euphy/polarshield_hardware/README.md

Polarshield Hardware
====================

This is the source for the Polarshield hardware, in EAGLE format.  
I have also included the last set of generated Gerber files that were used to make
the most recent batch of PCBs. These can be purchased through polargraph.bigcartel.com.
