euphy/polarshield_hardware/Polarshield v2.5.brd.png

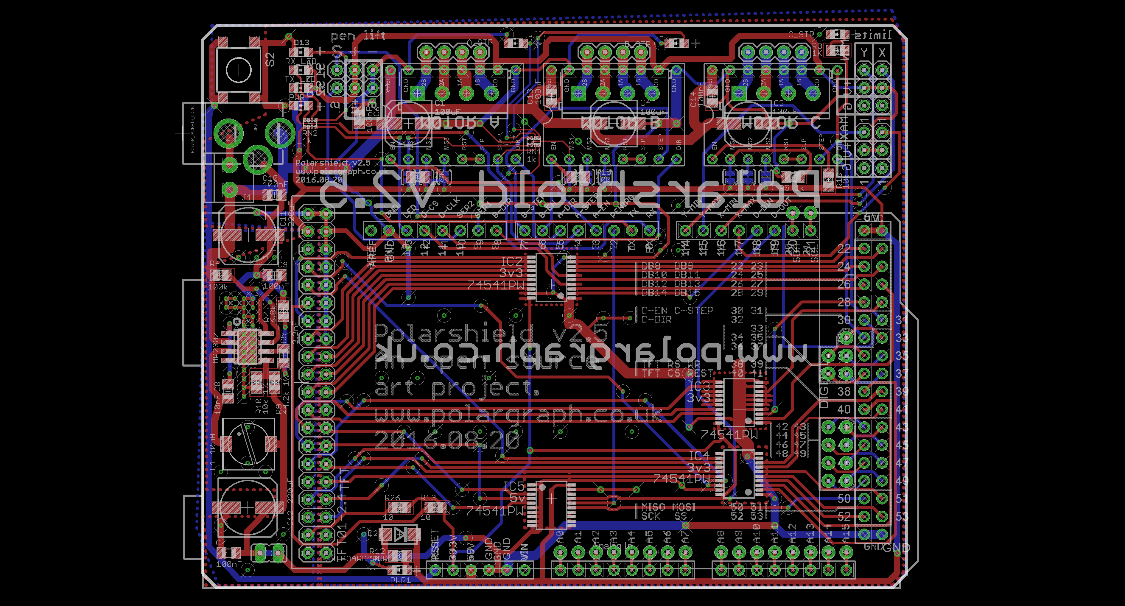
Polarshield v2.5.brd.png
