euphy/polarshield_hardware/Polarshield v2.5.sch.png

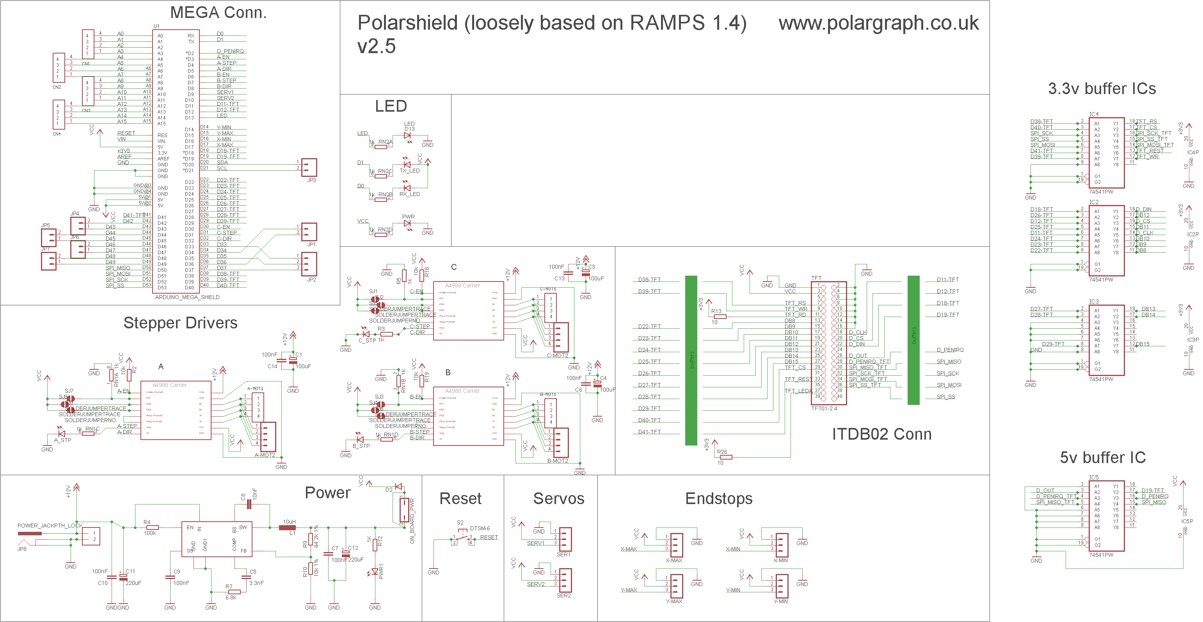
Polarshield v2.5.sch.png
