euphy/polarshield_hardware/Polarshield v2.6.brd

## EAGLE design Polarshield v2.6.brd (2017-02-12)

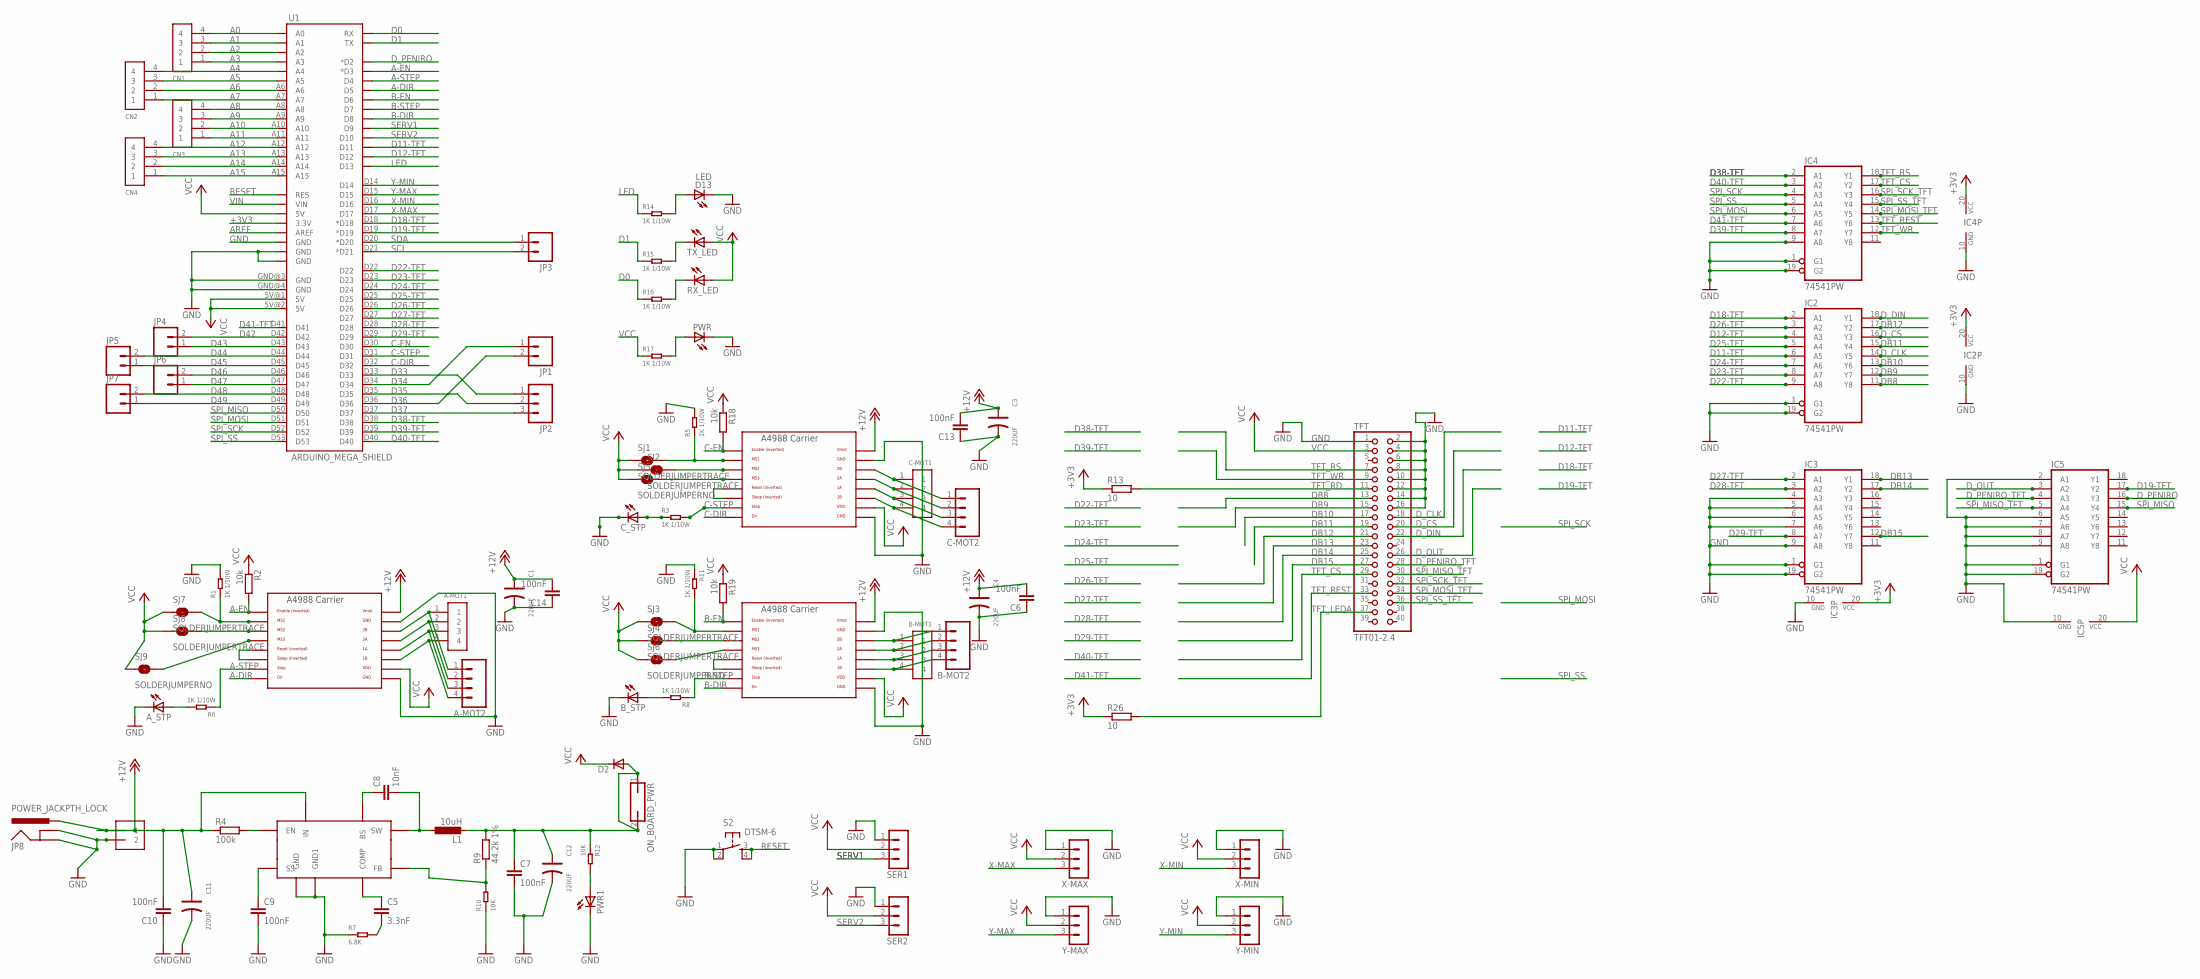
[picture p3: schematic Polarshield v2.6.sch]

Parts:
A-MOT1: 1X4-BIG; 1X04-BIG
A-MOT2: M04SCREW; SCREWTERMINAL-3.5MM-4
A_STP: LEDCHIP-LED0805; CHIP-LED0805
B-MOT1: 1X4-BIG; 1X04-BIG
B-MOT2: M04SCREW; SCREWTERMINAL-3.5MM-4
B_STP: LEDCHIP-LED0805; CHIP-LED0805
C1, C3, C4, C11, C12: 220UF; ELECTRO-SMD-C-6MM
C5: 3.3nF; C0402K
C6, C7, C9, C10, C13, C14: 100nF; C0402K
C8: 10nF; C0402K
C-MOT1: 1X4-BIG; 1X04-BIG
C-MOT2: M04SCREW; SCREWTERMINAL-3.5MM-4
CN1, CN2, CN3, CN4: 1X4-CLEANBIG; 1X04-CLEANBIG
C_STP: LEDCHIP-LED0805; CHIP-LED0805
D2: DIODE-DO214BA; DO214BA
D13: LED; CHIP-LED0805
IC1: MP2307; SOIC8
IC2, IC3, IC4, IC5: 74541PW; TSSOP20
J1: 1X2-3.5MM
JP1, JP3, JP4, JP5, JP6, JP7: M021X02_NO_SILK; 1X02_NO_SILK
JP2: M031X03_NO_SILK; 1X03_NO_SILK
JP8: POWER_JACKPTH_LOCK; POWER_JACK_PTH_LOCK
L1: 10uH; PIS2816
ON_BOARD_PWR: JP1Q; JP1
PWR, PWR1: LEDCHIP-LED0805; CHIP-LED0805
R1, R3, R5, R6, R8, R11, R14, R15, R16, R17: 1K 1/10W; R0603
R2, R18, R19: 10k; R0402
R4: 100k; R0603
R7: 6.8K; R0603
R9: 44.2k 1%; R0603
R10: 10K; R0805
R12: 10K; R0603
R13, R26: 10; R0603
RX_LED: LEDCHIP-LED0805; CHIP-LED0805
S2: DTSM-6
SER1, SER2: 3PIN-HEADER
SJ1, SJ2, SJ3, SJ4, SJ7, SJ8: SOLDERJUMPERTRACE; SJ_2S-TRACE
SJ5, SJ6, SJ9: SOLDERJUMPERNO; SJ_2S-NO
TFT: TFT01-2.4
TX_LED: LEDCHIP-LED0805; CHIP-LED0805
U1: ARDUINO_MEGA_SHIELD
U$1, U$6, U$7: A4988BREAKOUT
X-MAX: 3PIN-HEADER
X-MIN: 3PIN-HEADER
Y-MAX: 3PIN-HEADER
Y-MIN: 3PIN-HEADER

Connections:
+3V3: IC2.20 (VCC), IC3.20 (VCC), IC4.20 (VCC), R13.1, R26.1, U1.3.3V
+12V: C1.+, C3.+, C4.+, C6.2, C10.2, C11.+, C13.2, C14.2, IC1.IN, J1.1, JP8.PWR, R4.1, U$1.VMOT, U$6.VMOT, U$7.VMOT
A0: CN1.4, U1.A0
A1: CN1.3, U1.A1
A2: CN1.2, U1.A2
A3: CN1.1, U1.A3
A4: CN2.4, U1.A4
A5: CN2.3, U1.A5
A6: CN2.2, U1.A6
A7: CN2.1, U1.A7
A8: CN3.4, U1.A8
A9: CN3.3, U1.A9
A10: CN3.2, U1.A10
A11: CN3.1, U1.A11
A12: CN4.4, U1.A12
A13: CN4.3, U1.A13
A14: CN4.2, U1.A14
A15: CN4.1, U1.A15
A-DIR: U1.D5, U$1.DIR
A-EN: R2.2, U1.D3 (*D3), U$1.EN
A-STEP: R6.1, U1.D4, U$1.STEP
AREF: U1.AREF
B-DIR: U1.D8, U$7.DIR
B-EN: R19.2, U1.D6, U$7.EN
B-STEP: R8.1, U1.D7, U$7.STEP
C-DIR: U1.D32, U$6.DIR
C-EN: R18.2, U1.D30, U$6.EN
C-STEP: R3.2, U1.D31, U$6.STEP
D0: R16.1, U1.RX
D1: R15.1, U1.TX
D11-TFT: IC2.6 (A5), U1.D11
D12-TFT: IC2.4 (A3), U1.D12
D18-TFT: IC2.2 (A1), U1.D18 (*D18)
D19-TFT: IC5.17 (Y2), U1.D19 (*D19)
D22-TFT: IC2.9 (A8), U1.D22
D23-TFT: IC2.8 (A7), U1.D23
D24-TFT: IC2.7 (A6), U1.D24
D25-TFT: IC2.5 (A4), U1.D25
D26-TFT: IC2.3 (A2), U1.D26
D27-TFT: IC3.2 (A1), U1.D27
D28-TFT: IC3.3 (A2), U1.D28
D29-TFT: IC3.8 (A7), U1.D29
D33: JP2.1, U1.D33
D34: JP1.1, U1.D34
D35: JP2.2, U1.D35
D36: JP1.2, U1.D36
D37: JP2.3, U1.D37
D38-TFT: IC4.2 (A1), U1.D38
D39-TFT: IC4.8 (A7), U1.D39
D40-TFT: IC4.3 (A2), U1.D40
D41-TFT: IC4.7 (A6), U1.D41
D42: JP4.2, U1.D42
D43: JP4.1, U1.D43
D44: JP5.2, U1.D44
D45: JP5.1, U1.D45
D46: JP6.2, U1.D46
D47: JP6.1, U1.D47
D48: JP7.2, U1.D48
D49: JP7.1, U1.D49
DB8: IC2.11 (Y8), TFT.13
DB9: IC2.12 (Y7), TFT.15
DB10: IC2.13 (Y6), TFT.17
DB11: IC2.15 (Y4), TFT.19
DB12: IC2.17 (Y2), TFT.21
DB13: IC3.18 (Y1), TFT.23
DB14: IC3.17 (Y2), TFT.25
DB15: IC3.12 (Y7), TFT.27
D_CLK: IC2.14 (Y5), TFT.18
D_CS: IC2.16 (Y3), TFT.20
D_DIN: IC2.18 (Y1), TFT.22
D_OUT: IC5.3 (A2), TFT.26
D_PENIRQ: IC5.16 (Y3), U1.D2 (*D2)
D_PENIRQ_TFT: IC5.4 (A3), TFT.28
GND: A_STP.C, B_STP.C, C1.-, C3.-, C4.-, C6.1, C7.2, C9.2, C10.1, C11.-, C12.-, C13.1, C14.1, C_STP.C, D13.C, IC1.GND, IC1.GND1, IC2.1 (G1), IC2.10 (GND), IC2.19 (G2), IC3.1 (G1), IC3.4 (A3), IC3.5 (A4), IC3.6 (A5), IC3.7 (A6), IC3.9 (A8), IC3.10 (GND), IC3.19 (G2), IC4.1 (G1), IC4.9 (A8), IC4.10 (GND), IC4.19 (G2), IC5.1 (G1), IC5.2 (A1), IC5.6 (A5), IC5.7 (A6), IC5.8 (A7), IC5.9 (A8), IC5.10 (GND), IC5.19 (G2), J1.2, JP8.GND, JP8.GNDBREAK, PWR.C, PWR1.C, R1.2, R5.2, R7.1, R10.1, R11.1, S2.1, S2.2, SER1.1, SER2.1, TFT.1, TFT.2, TFT.4, TFT.6, TFT.8, TFT.10, TFT.12, TFT.14, TFT.16, U1.GND@0 (GND), U1.GND@1 (GND), U1.GND@2 (GND), U1.GND@3 (GND), U1.GND@4 (GND), U$1.GND, U$1.GND@0 (GND), U$6.GND, U$6.GND@0 (GND), U$7.GND, U$7.GND@0 (GND), X-MAX.1, X-MIN.1, Y-MAX.1, Y-MIN.1
LED: R14.1, U1.D13
unnamed: U$6.RST, U$6.SLP (SLEEP)
unnamed: PWR.A, R17.2
unnamed: R5.1, SJ1.2, U$6.MS1
unnamed: A-MOT1.1, A-MOT2.1, U$1.2B
unnamed: A-MOT1.2, A-MOT2.2, U$1.2A
unnamed: A-MOT1.3, A-MOT2.3, U$1.1A
unnamed: A-MOT1.4, A-MOT2.4, U$1.1B
unnamed: U$1.RST, U$1.SLP (SLEEP)
unnamed: R1.1, SJ7.2, U$1.MS1
unnamed: SJ2.2, U$6.MS2
unnamed: SJ8.2, U$1.MS2
unnamed: SJ5.2, U$6.MS3
unnamed: U$7.RST, U$7.SLP (SLEEP)
unnamed: SJ9.2, U$1.MS3
unnamed: R16.2, RX_LED.C
unnamed: R15.2, TX_LED.C
unnamed: SJ4.2, U$7.MS2
unnamed: B_STP.A, R8.2
unnamed: A_STP.A, R6.2
unnamed: D13.A, R14.2
unnamed: C-MOT1.1, C-MOT2.1, U$6.2B
unnamed: C-MOT1.2, C-MOT2.2, U$6.2A
unnamed: C_STP.A, R3.1
unnamed: C7.1, C12.+, D2.A, L1.2, ON_BOARD_PWR.1, ON_BOARD_PWR.2, R9.2, R12.1
unnamed: PWR1.A, R12.2
unnamed: C-MOT1.3, C-MOT2.3, U$6.1A
unnamed: C-MOT1.4, C-MOT2.4, U$6.1B
unnamed: B-MOT1.1, B-MOT2.1, U$7.2B
unnamed: B-MOT1.2, B-MOT2.2, U$7.2A
unnamed: B-MOT1.3, B-MOT2.3, U$7.1A
unnamed: SJ6.2, U$7.MS3
unnamed: IC1.FB, R9.1, R10.2
unnamed: R11.2, SJ3.2, U$7.MS1
unnamed: IC1.EN, R4.2
unnamed: B-MOT1.4, B-MOT2.4, U$7.1B
unnamed: C9.1, IC1.SS
unnamed: C5.2, R7.2
unnamed: C5.1, IC1.COMP
unnamed: C8.1, IC1.BS
unnamed: C8.2, IC1.SW, L1.1
RESET: S2.3, S2.4, U1.RES
SCL: JP3.2, U1.D21 (*D21)
SDA: JP3.1, U1.D20 (*D20)
SERV1: SER1.3, U1.D9
SERV2: SER2.3, U1.D10
SPI_MISO: IC5.15 (Y4), U1.D50
SPI_MISO_TFT: IC5.5 (A4), TFT.30
SPI_MOSI: IC4.6 (A5), U1.D51
SPI_MOSI_TFT: IC4.14 (Y5), TFT.34
SPI_SCK: IC4.4 (A3), U1.D52
SPI_SCK_TFT: IC4.16 (Y3), TFT.32
SPI_SS: IC4.5 (A4), U1.D53
SPI_SS_TFT: IC4.15 (Y4), TFT.36
TFT_CS: IC4.17 (Y2), TFT.29
TFT_LEDA: R26.2, TFT.37
TFT_RD: R13.2, TFT.11
TFT_REST: IC4.13 (Y6), TFT.33
TFT_RS: IC4.18 (Y1), TFT.7
TFT_WR: IC4.12 (Y7), TFT.9
VCC: D2.C, IC5.20 (VCC), R2.1, R17.1, R18.1, R19.1, RX_LED.A, SER1.2, SER2.2, SJ1.1, SJ2.1, SJ3.1, SJ4.1, SJ5.1, SJ6.1, SJ7.1, SJ8.1, SJ9.1, TFT.3, TX_LED.A, U1.5V@0 (5V), U1.5V@1 (5V), U1.5V@2 (5V), U$1.VDD, U$6.VDD, U$7.VDD, X-MAX.2, X-MIN.2, Y-MAX.2, Y-MIN.2
VIN: U1.VIN
X-MAX: U1.D17, X-MAX.3
X-MIN: U1.D16, X-MIN.3
Y-MAX: U1.D15, Y-MAX.3
Y-MIN: U1.D14, Y-MIN.3

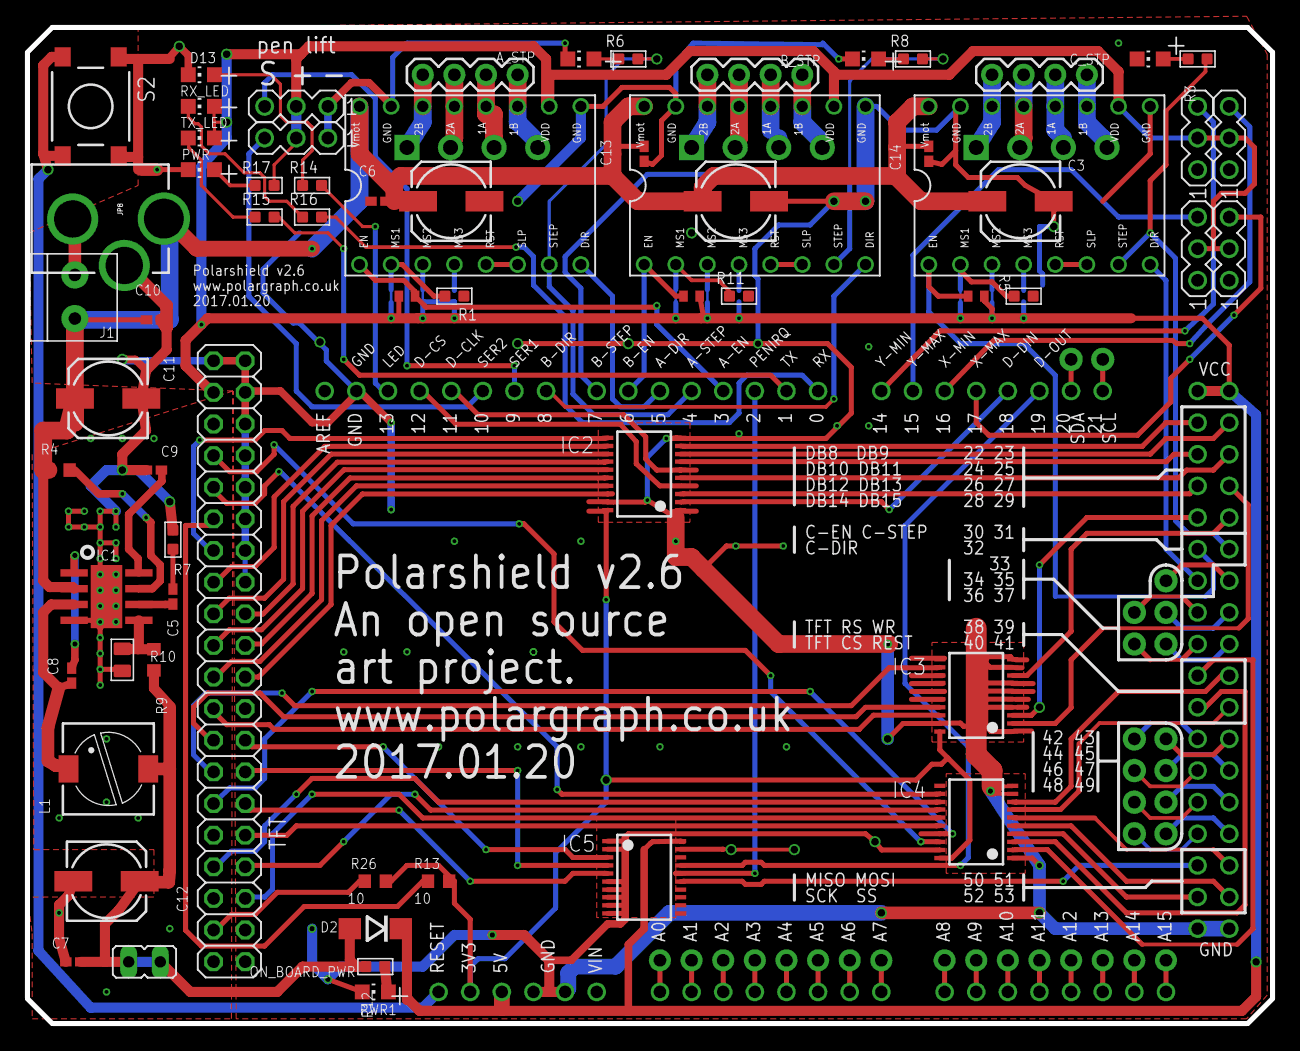
[picture p4: board Polarshield v2.6.brd from above]

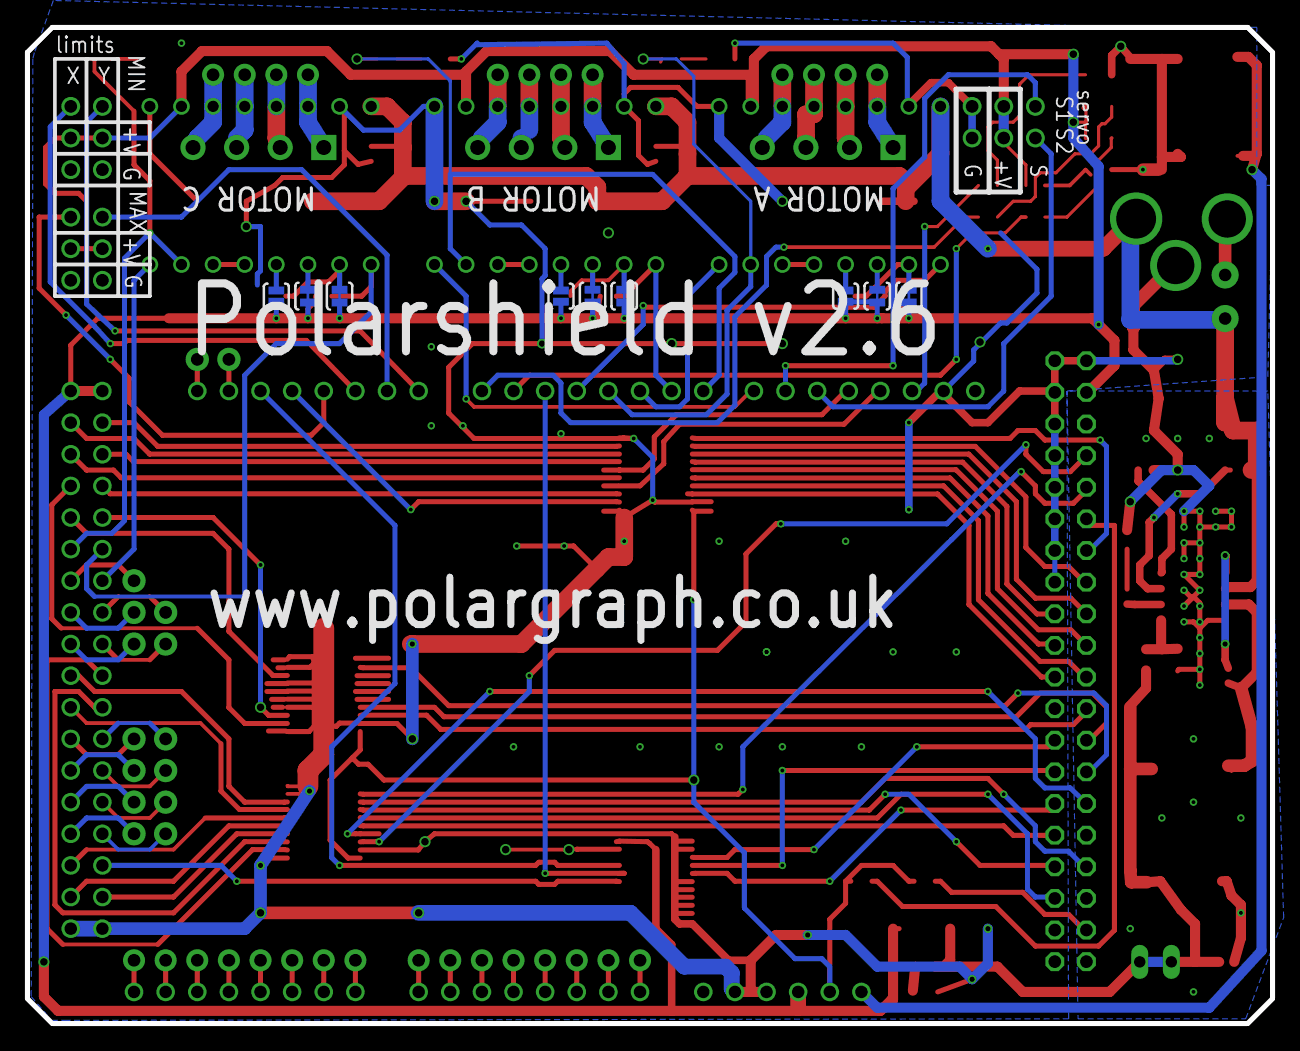
[picture p5: board Polarshield v2.6.brd from below]

Board: 4 copper layers, 100.0 x 80.0 mm, 89 parts (9 on the bottom side), 138 nets.
