euphy/polarshield_hardware/(commit log)

2013-08-28 Init upload of polarshield board files
    [11153-SandyNoble-Polarshieldv1.0.brd, 11153-SandyNoble-Polarshieldv1.0.dxf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]
2013-08-28 swapped motor A, C. Moved servo and endstops.
2013-08-31 Added some LEDs for rx, tx and step
    [Polarshield v1.5.brd]
2013-08-31 Finished v1.5 and sent off to be made.
    [Order339582-10x10-SandyNoble-Polarshieldv1.5.GBL, Order339582-10x10-SandyNoble-Polarshieldv1.5.GBO, Order339582-10x10-SandyNoble-Polarshieldv1.5.GBP, Order339582-10x10-SandyNoble-Polarshieldv1.5.GBS, Order339582-10x10-SandyNoble-Polarshieldv1.5.GTL, Order339582-10x10-SandyNoble-Polarshieldv1.5.GTO, Order339582-10x10-SandyNoble-Polarshieldv1.5.GTP, Order339582-10x10-SandyNoble-Polarshieldv1.5.GTS]
2013-09-13 Added fixed v1.5. Cosmetic only, but rezipped because I messed up the file upload and THESE BOARDS ARE WORTHLESS!! Well I have fixed and reuploaded. This is functionally identical, so no version incr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
    [Order339667-10x10-SandyNoble-Polarshieldv1.5.GBL, Order339667-10x10-SandyNoble-Polarshieldv1.5.GBO, Order339667-10x10-SandyNoble-Polarshieldv1.5.GBP, Order339667-10x10-SandyNoble-Polarshieldv1.5.GBS, Order339667-10x10-SandyNoble-Polarshieldv1.5.GTL, Order339667-10x10-SandyNoble-Polarshieldv1.5.GTO, Order339667-10x10-SandyNoble-Polarshieldv1.5.GTP, Order339667-10x10-SandyNoble-Polarshieldv1.5.GTS]
2013-10-18 Merged a resistor into a network and changed a few values, also cleaned up silkscreen.
    [Order339667-10x10-SandyNoble-Polarshieldv1.5.dxf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]
2013-11-26 Added dxf that I used for the screen printing.
2013-11-26 Removed a load of old versions.
    [11153-SandyNoble-Polarshieldv1.0.brd, 11153-SandyNoble-Polarshieldv1.0.dxf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]
2014-01-29 Couple updates.
2014-01-29 Revert "Removed a load of old versions."
    This reverts commit 932d87ee5b56b293ae88f7cca643fe68918375a7.
    [11153-SandyNoble-Polarshieldv1.0.brd, 11153-SandyNoble-Polarshieldv1.0.dxf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]
2014-02-03 Revert "Revert "Removed a load of old versions.""
    This reverts commit 689725b0dcb57211e49b9427af1c8fa31b99f5e5.
    [11153-SandyNoble-Polarshieldv1.0.brd, 11153-SandyNoble-Polarshieldv1.0.dxf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]
2014-04-29 Files as sent to board mfr 29.04.2014.
    [Polarshield v1.7.GBL, Polarshield v1.7.GBO, Polarshield v1.7.GBP, Polarshield v1.7.GBS, Polarshield v1.7.GTL, Polarshield v1.7.GTO, Polarshield v1.7.GTP, Polarshield v1.7.GTS]
2014-05-12 v2.0 really
    First attempt.
    [Polarshield v1.7.csv]
2014-06-08 v2c that has gone to the PCB makers last night.
    [Polarshield v2.0c.GBL, Polarshield v2.0c.GBO, Polarshield v2.0c.GBP, Polarshield v2.0c.GBS, Polarshield v2.0c.GTL, Polarshield v2.0c.GTO, Polarshield v2.0c.GTP, Polarshield v2.0c.GTS]
2014-06-08 Version 2.0d
    [Polarshield v2.0d.brd, Polarshield v2.0d.sch]
2014-08-08 Got rid of some old files.
    [Polarshield v2.0.GBL, Polarshield v2.0.GBO, Polarshield v2.0.GBP, Polarshield v2.0.GBS, Polarshield v2.0.GTL, Polarshield v2.0.GTO, Polarshield v2.0.GTP, Polarshield v2.0.GTS]
2015-04-18 Updated polarshield to v2.1
    [OrderPIEF101613-03_10x10-SandyNoble-Polarshieldv1.6.GBL, OrderPIEF101613-03_10x10-SandyNoble-Polarshieldv1.6.GBO, OrderPIEF101613-03_10x10-SandyNoble-Polarshieldv1.6.GBP, OrderPIEF101613-03_10x10-SandyNoble-Polarshieldv1.6.GBS, OrderPIEF101613-03_10x10-SandyNoble-Polarshieldv1.6.GTL, OrderPIEF101613-03_10x10-SandyNoble-Polarshieldv1.6.GTO, OrderPIEF101613-03_10x10-SandyNoble-Polarshieldv1.6.GTP, 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]
2015-04-18 Ran the DRU, ready for making.
    [Polarshield v2.1.brd, Polarshield v2.1.sch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]
2015-11-19 Updated to v2.2a: Made a couple holes smaller, rebuilt gerbers properly.
    [Polarshield v2.2a.GBL, Polarshield v2.2a.GBO, Polarshield v2.2a.GBP, Polarshield v2.2a.GBS, Polarshield v2.2a.GTL, Polarshield v2.2a.GTO, Polarshield v2.2a.GTP, Polarshield v2.2a.GTS]
2016-02-18 Added v2.3
    [Polarshield v2.3.GBL, Polarshield v2.3.GBO, Polarshield v2.3.GBP, Polarshield v2.3.GBS, Polarshield v2.3.GTL, Polarshield v2.3.GTO, Polarshield v2.3.GTP, Polarshield v2.3.GTS]
2016-04-04 v2.2 (missing silkscreen)
    [Polarshield v2.2.GBL, Polarshield v2.2.GBO, Polarshield v2.2.GBP, Polarshield v2.2.GBS, Polarshield v2.2.GTL, Polarshield v2.2.GTO, Polarshield v2.2.GTP, Polarshield v2.2.GTS]
2016-04-04 v2.2.1 aka v2.2a - added missing silkscreen
    [Polarshield v2.2_.GBL, Polarshield v2.2_.GBO, Polarshield v2.2_.GBP, Polarshield v2.2_.GBS, Polarshield v2.2_.GTL, Polarshield v2.2_.GTO, Polarshield v2.2_.GTP, Polarshield v2.2_.GTS]
2016-04-04 Removing old versions
    [Polarshield v2.0d.brd, Polarshield v2.0d.sch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]
2017-02-12 Polarshield 2.5 gerbers and source
    [Polarshield v2.5 BOM.csv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]
2017-02-12 Added 2.6
    [Polarshield v2.6.brd, Polarshield v2.6.sch]
2017-02-12 Removing v2.4
    [Polarshield v2.4.GBL, Polarshield v2.4.GBO, Polarshield v2.4.GBP, Polarshield v2.4.GBS, Polarshield v2.4.GTL, Polarshield v2.4.GTO, Polarshield v2.4.GTP, Polarshield v2.4.GTS]
2017-06-26 Made sch more readable
    [Polarshield v2.5.sch]
